ahermann86/LX79x_WiFi/README.md

# LX79x Mähroboter WiFi Erweiterung mit ESP32

Nachrüstung einer WiFi Schnittstelle mit Websteuerung für einen LandXcape LX79x Mähroboter

*Der Einsatz von diesem Projekt erfolgt auf eigene Gefahr! Der Ersteller kann nicht für Schäden haftbar gemacht werden. Sie können einen Verlust der Garantie und des Supports durch den Hersteller riskieren! Dieses Projekt ist keine offizielle Erweiterung des Roboters!*

<p align="center">
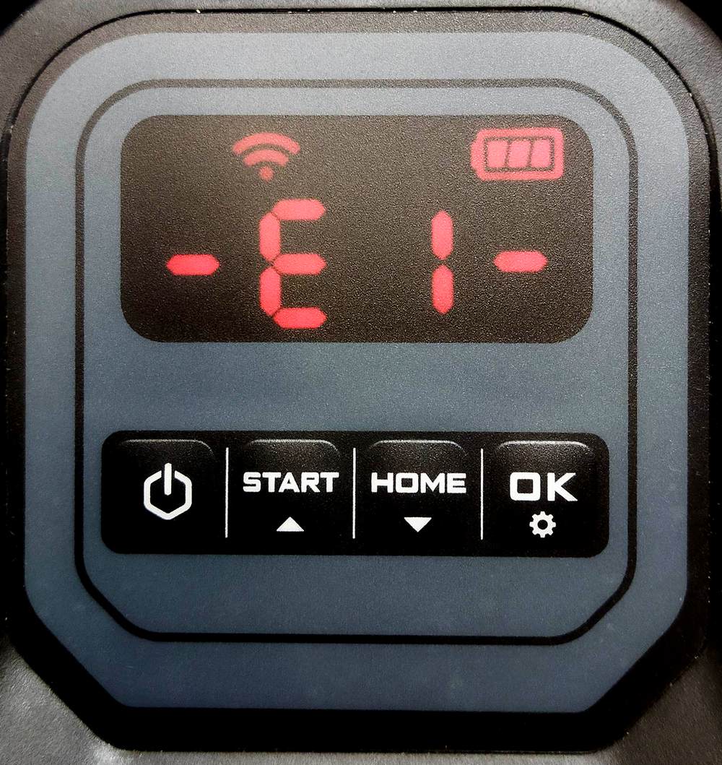
[picture p1: pic/Display.jpg]
  
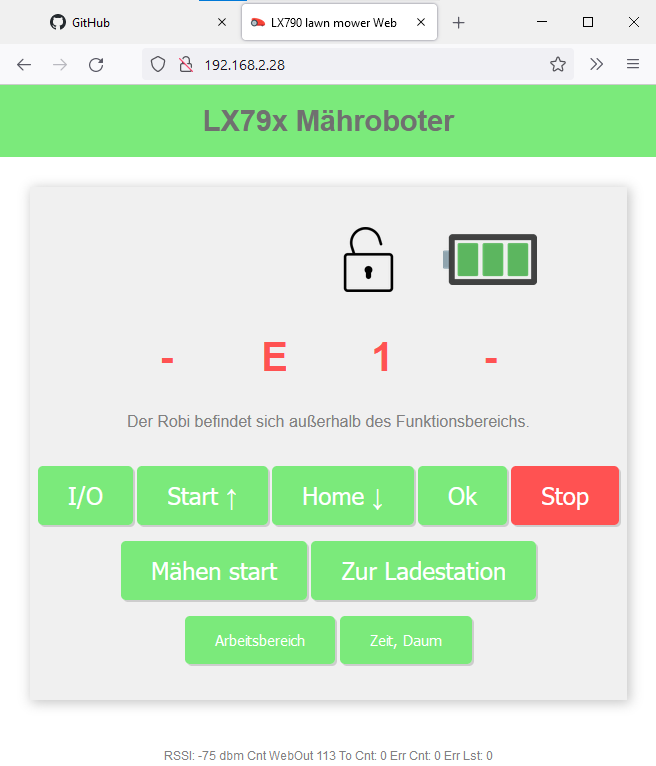
[picture p2: pic/Web_with_mower.png]
  
</p>

### Allgemein
- Fernauslesen des Displays
- Klartextausgabe der Fehlercodes
- Fernsteuern der Tasten und Funktionen
- Anbindung über den I2C Bus zwischen Display und Mainboard
- Wenn der Roboter in der Ladestation steht uns aus ist, kann dieser mit "I/O" eingeschaltet werden

### Voraussetzungen
#### Hardware
Zum Einsatz kommt der ESP32 auf dem Board "DOIT ESP32 DEVKIT V1". Dieser wurde gewählt, da er zwei Hardware I2C Schnittstellen besitzt. Das ist wichtig, da beim I2C Bus des Roboters das Timing nicht zu sehr beeinflusst werden darf.

##### Anbindung an den I2C Bus
Um den ESP32 in den I2C Bus zwischen Mainboard und Display zwischenschalten zu können, benötigt man ein Adapterkabel. Dabei muss am Roboter selbst nichts "umgebaut" werden. Es wird lediglich der Stecker des Displays ausgesteckt und ein Adapter wie folgt dazwischen gesteckt:
<p align="center">
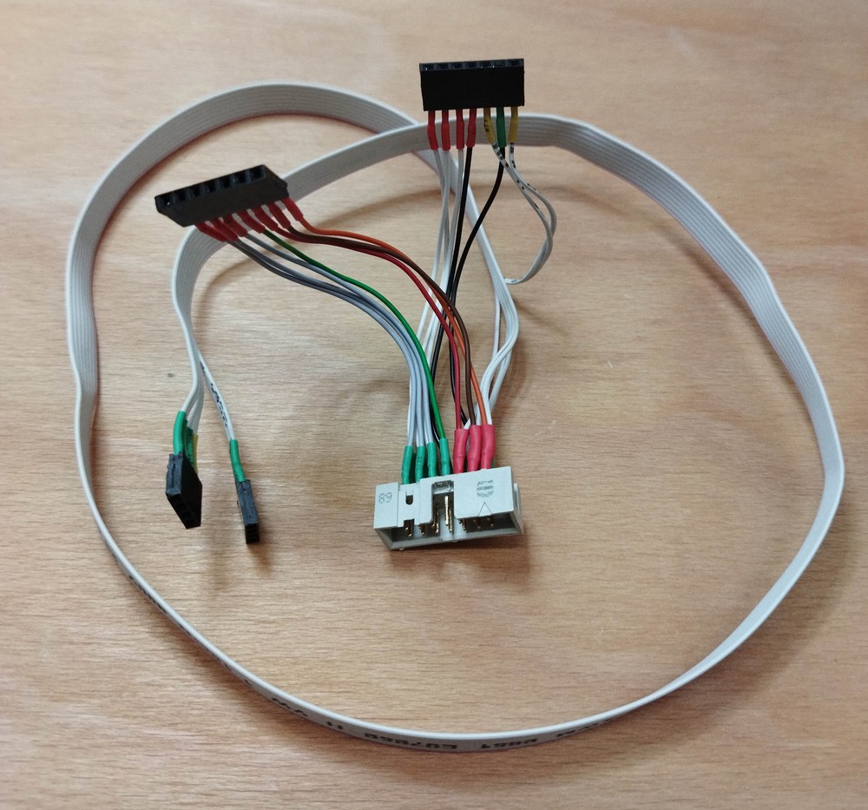
[picture p3: pic/Adapter_1.jpg]
  
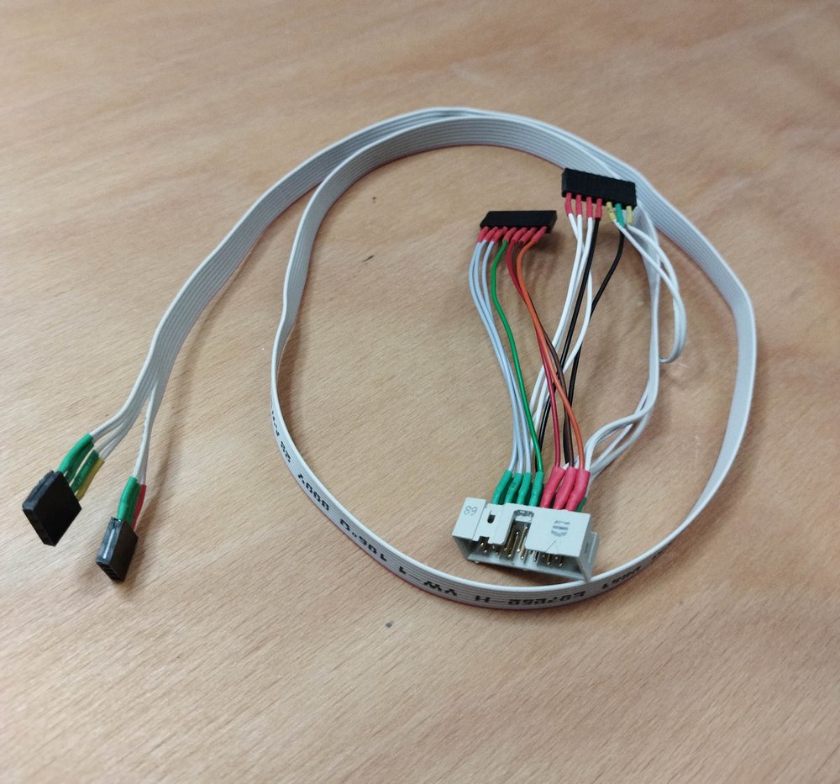
[picture p4: pic/Adapter_2.jpg]
  
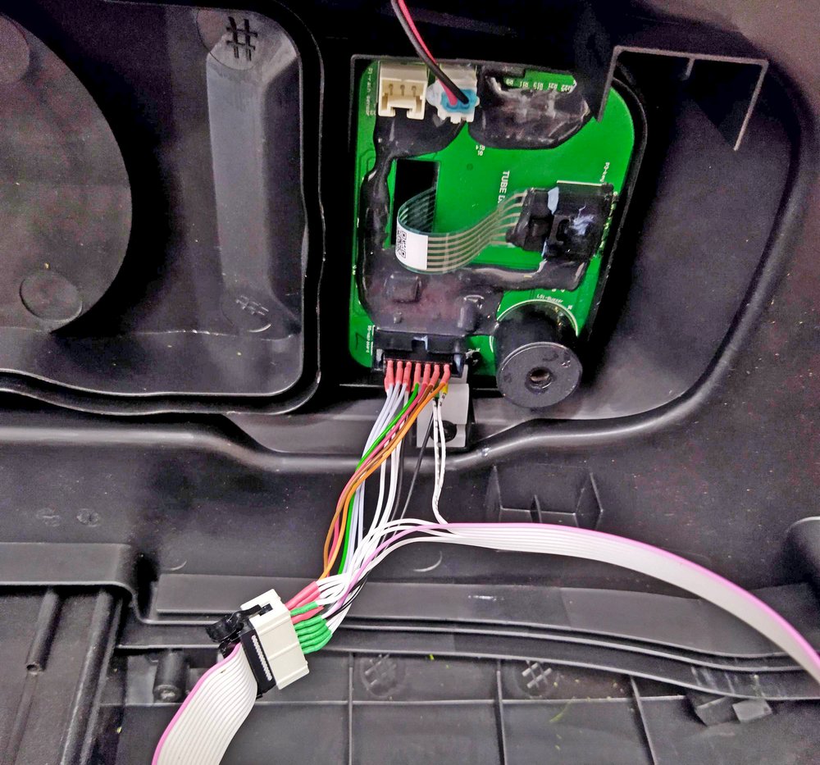
[picture p5: pic/Display_1.jpg]
    
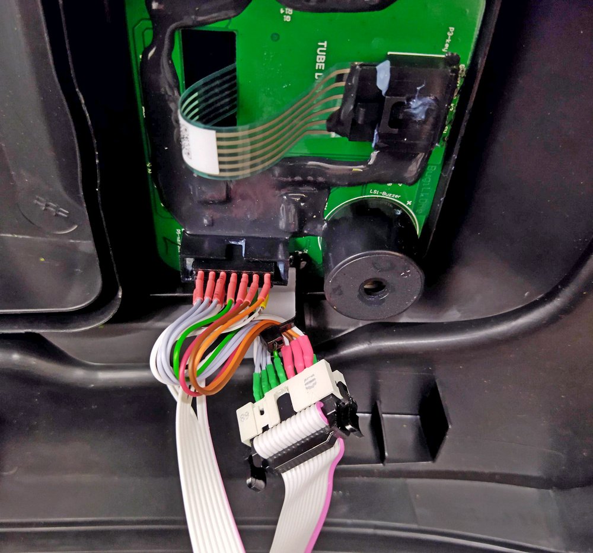
[picture p6: pic/Display_2.jpg]
    
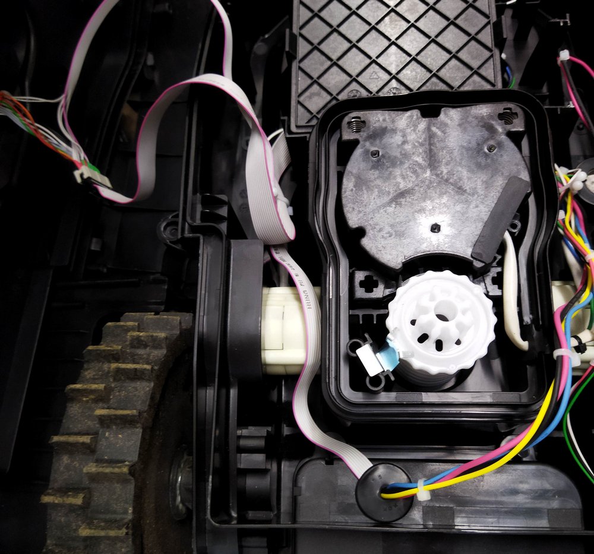
[picture p7: pic/Durchgang_1.jpg]
    
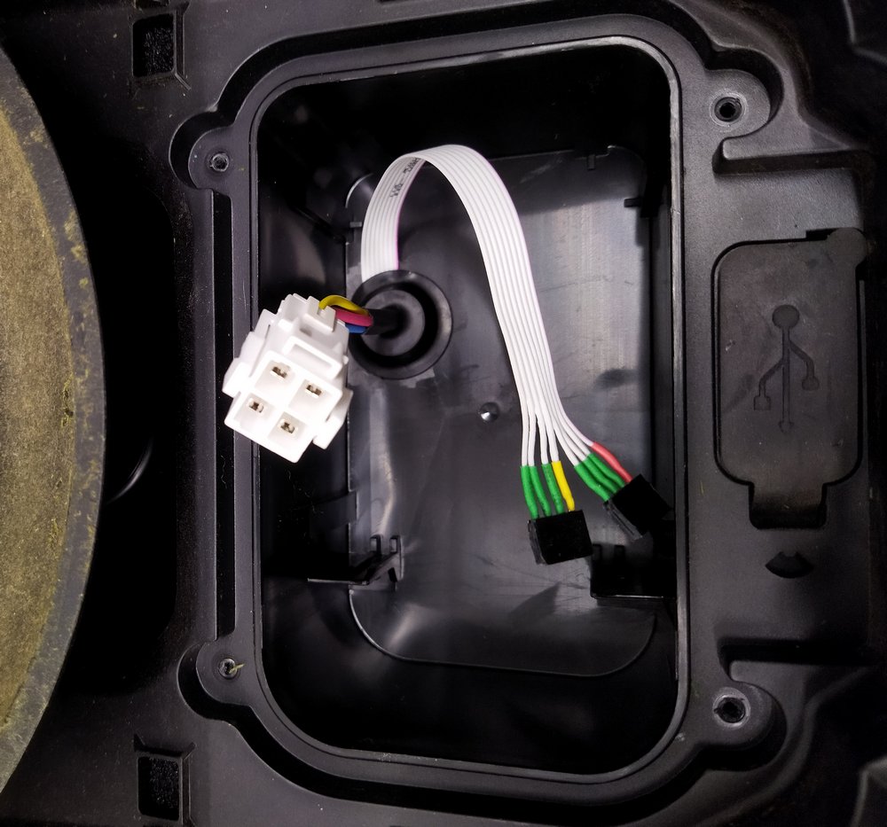
[picture p8: pic/Durchgang_2.jpg]
    
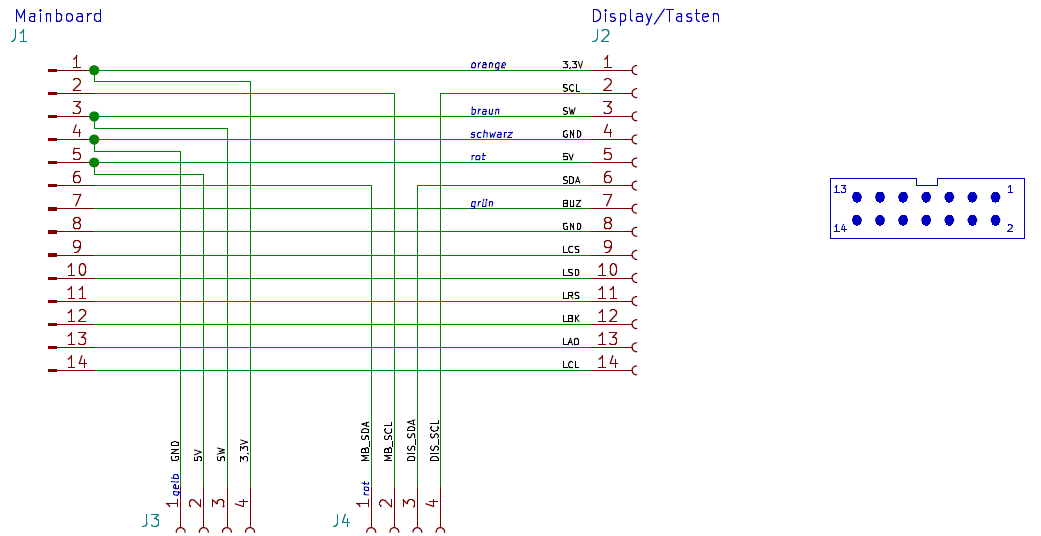
[picture p9: pic/Schaltplan_Adapter.png]
    
</p>

Das Adapterkabel hat eine Gesamtlänge von ca 70cm.

##### Platine
Der ESP32 wird auf eine Lochrasterplatine Adaptiert. Die fertige Platine kann dann in dem Batteriefach eingebaut werden.
<p align="center">
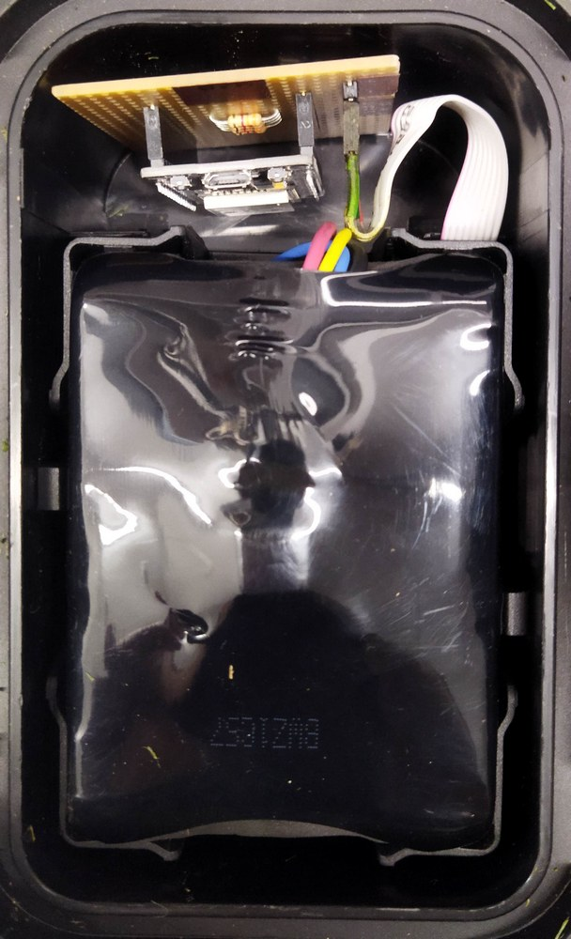
[picture p10: pic/Eingebaut_1.jpg]
  
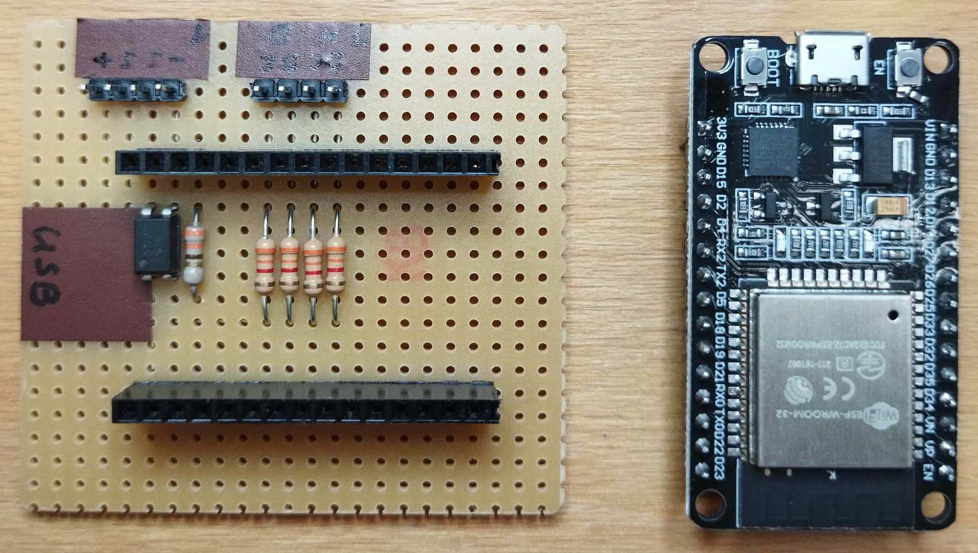
[picture p11: pic/Platine_1.jpg]
  
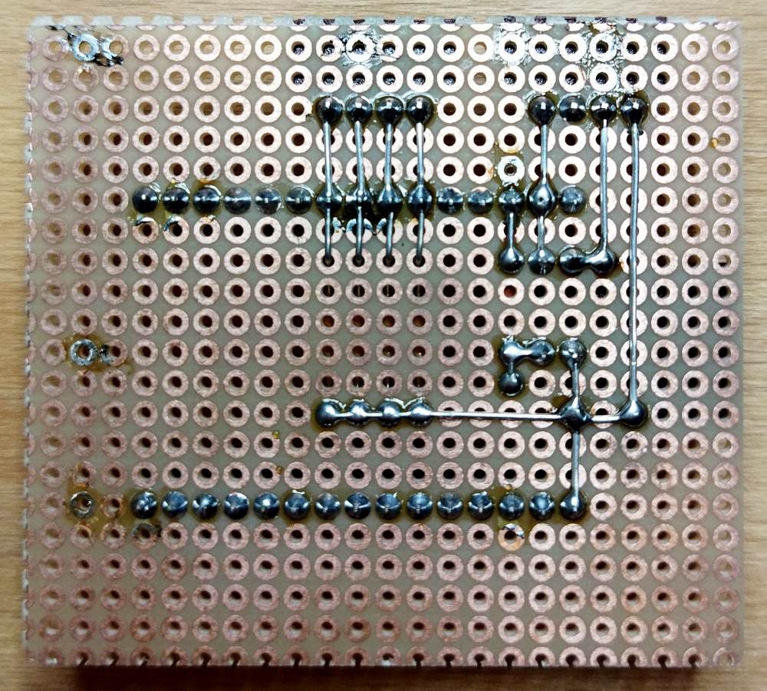
[picture p12: pic/Platine_2.jpg]
  
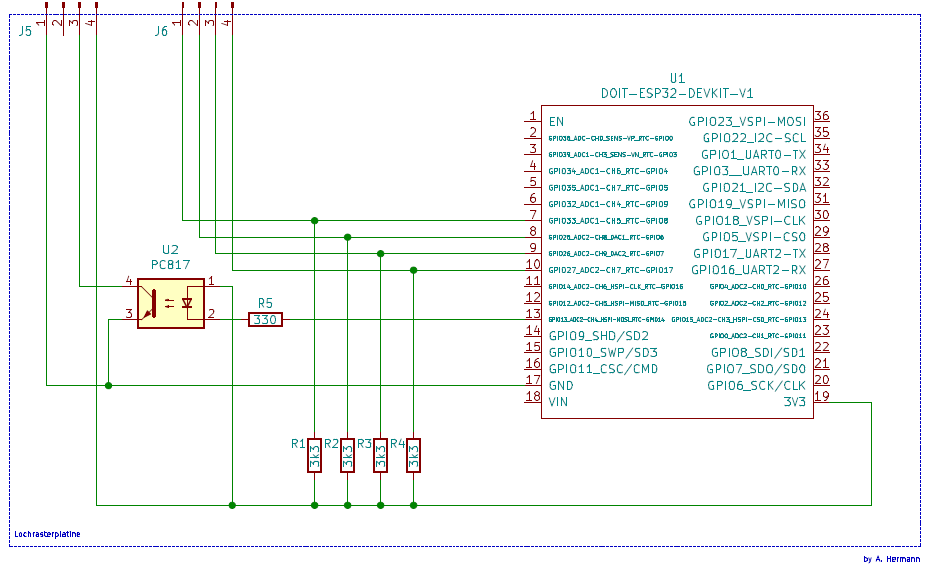
[picture p13: pic/Schaltplan_ESP32.png]
  
</p>

[Gesamter Schaltplan als PDF](pic/Schaltplan.pdf)

#### Software
Um den ESP32 programmieren und flashen zu können, wurde in diesem Projekt die Arduino IDE eingesetzt.

##### Folgende Voraussetzungen müssen dafür geschaffen werden:
1. Installation der aktuellen Arduino IDE
2. ESP32 Core installieren (https://docs.espressif.com/projects/arduino-esp32/en/latest/installing.html)
3. Boardtyp auswählen: 'Werkzeuge->Board->DOIT ESP32 DEVKIT V1'
4. CRC Bibliothek ergänzen: 'Werkzeuge->Bibliotheken verwalten...->CRC (Rob Tillaart)'
5. Filesystem Uploader: (https://randomnerdtutorials.com/install-esp32-filesystem-uploader-arduino-ide/)
  1. Download ESP32FS ZIP: https://github.com/me-no-dev/arduino-esp32fs-plugin/releases/
  2. ZIP direkt in "c:\Program Files (x86)\Arduino\tools\" entpacken
  3. Arduino IDE neu starten

##### ESP32 flashen/Programm und Daten uploaden:
1. Repository herunterladen und "ino" Projektdatei öffnen
2. ESP32 Board per USB verbinden und passende COM Schnittstelle auswählen: 'Werkzeuge->Port'
3. Im .ino Code die WiFi Zugangsdaten anpassen:
```c
const char* ssid     = "DEINESSID";
const char* password = "DEINPASSWORT";
```
4. Ordner "data" mit 'Werkzeuge->ESP32 Sketch Data Upload' hochladen
5. Seriellen Monitor öffnen
6. Projekt kompilieren und hochladen
7. Über Seriellen Monitor kontrollieren ob WiFi Verbindung besteht und IP Adresse, welche vom DHCP Server vergeben wurde, ermitteln bzw. merken.

### Anwendung
#### Webbrowser
Das Webinterface kann direkt mit der IP Adresse aufgerufen werden:
<p align="center">
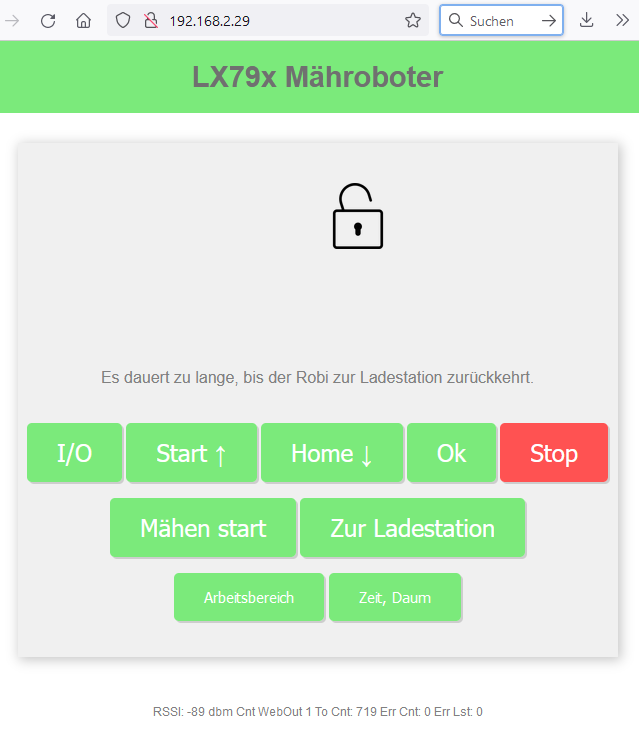
[picture p14: pic/Web_without_mower.png]
  
</p>

#### HTTP Anfragemethoden
##### Befehle Senden
http://MOWERADRESS/cmd?parm=[COMMAND]&value=[VALUE]

param=[COMMAND]:

- start -> Taste Start bzw. hoch
- home -> Taste Home bzw. runter
- ok -> Taste Ok
- stop -> Taste Stop
- workzone -> Arbeitsbereich einstellen
- timedate -> Zeit und Datum einstellen
- startmow -> "Mähen" starten
- homemow -> "Zurück zur Ladestation" starten

value=[VALUE]:

- Bei "start, home, ok, stop" ist [VALUE] die Dauer in ms des Tastendrucks ansonsten muss 1 übergeben werden.

>Beispiel - die Taste Start soll 5 Sekunden gedrückt werden:
>
>http://MOWERADRESS/cmd?parm=start&value=5000

##### Zustand Abfragen
http://MOWERADRESS/statval

Antwort:
[Display];[RSSI];[Batteriestatus];[Klartext]

>Beispiel bei Fehler:
>
>-E8-;-83;off;Es dauert zu lange, bis der Robi zur Ladestation zurückkehrt.
>
>Beispiel während dem Mähen:
>
>|--|;-80;mid;Mähen...

##### Beispiel
Einbindung in FHEM per HTTPMOD:

```
defmod MRoboter HTTPMOD none 5
attr MRoboter alias MRoboter
attr MRoboter event-on-change-reading .*
attr MRoboter get01-1Name Display
attr MRoboter get01-2Name RSSI
attr MRoboter get01-3Name Battery
attr MRoboter get01-4Name Status
attr MRoboter get01Decode UTF-8
attr MRoboter get01Name Ouput
attr MRoboter get01Poll 1
attr MRoboter get01Regex (\N+);;(\N+);;(\N+);;(\N+)
attr MRoboter get01URL http://192.168.2.54:80/statval
attr MRoboter group Mähroboter
attr MRoboter room Haus
attr MRoboter showBody 1
attr MRoboter stateFormat D: Display WL: RSSI S: Status B: Battery
```

Eine Aufzeichnung sieht dann so aus:

<p align="center">
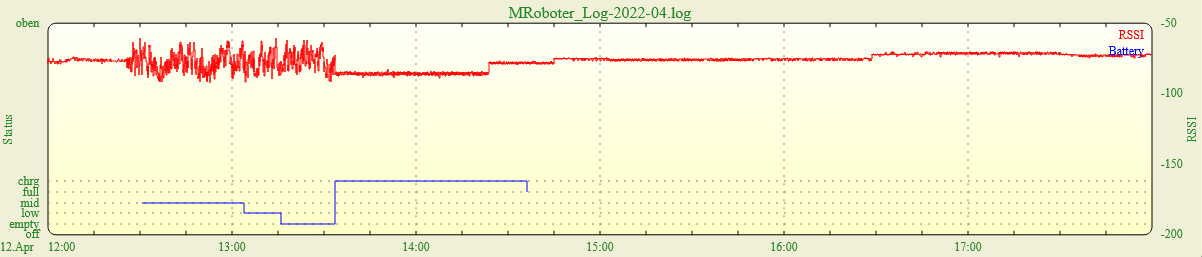
[picture p15: pic/LogPlot_mit_FHEM.png]
  
</p>

##### Update ausführen
http://MOWERADRESS/update

Damit kann eine .bin Datei auf den ESP32 hochgeladen werden.
