ahermann86/LX79x_WiFi/pic/Oszi_01Req_01Res.PNG

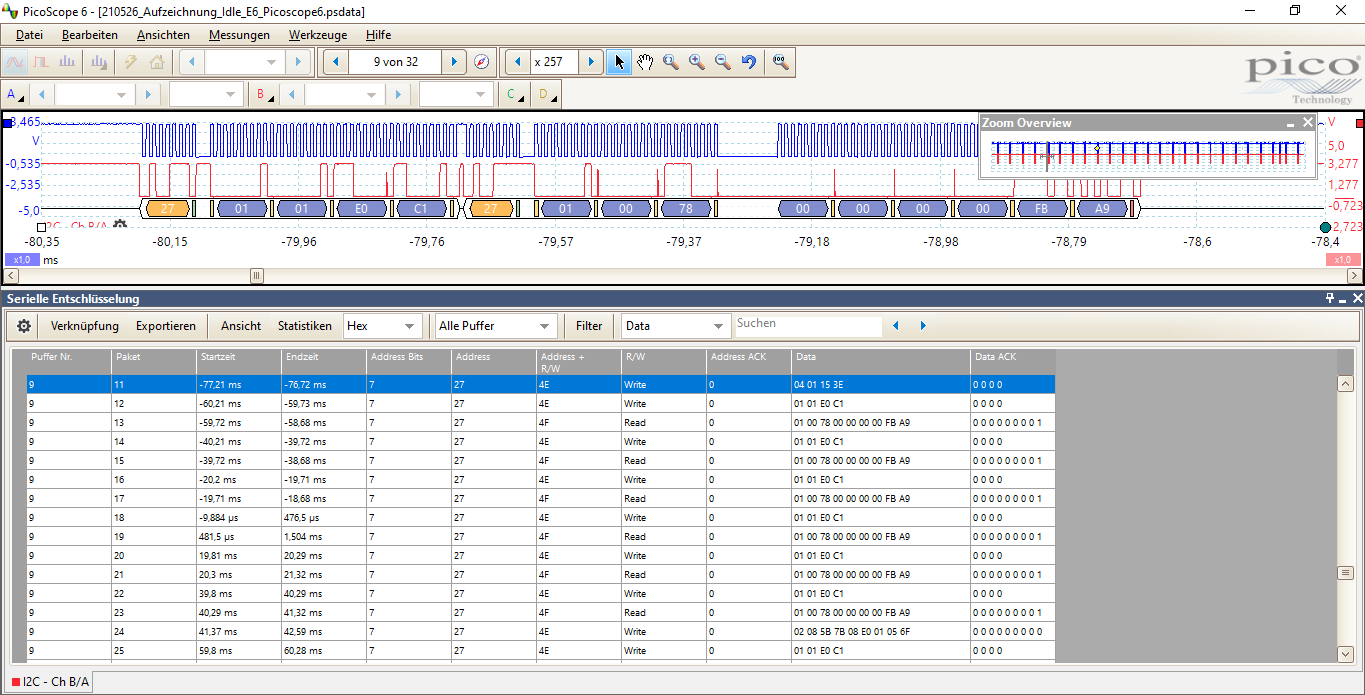
pic/Oszi_01Req_01Res.PNG
