ahermann86/LX79x_WiFi/pic/Oszi_02Res.PNG

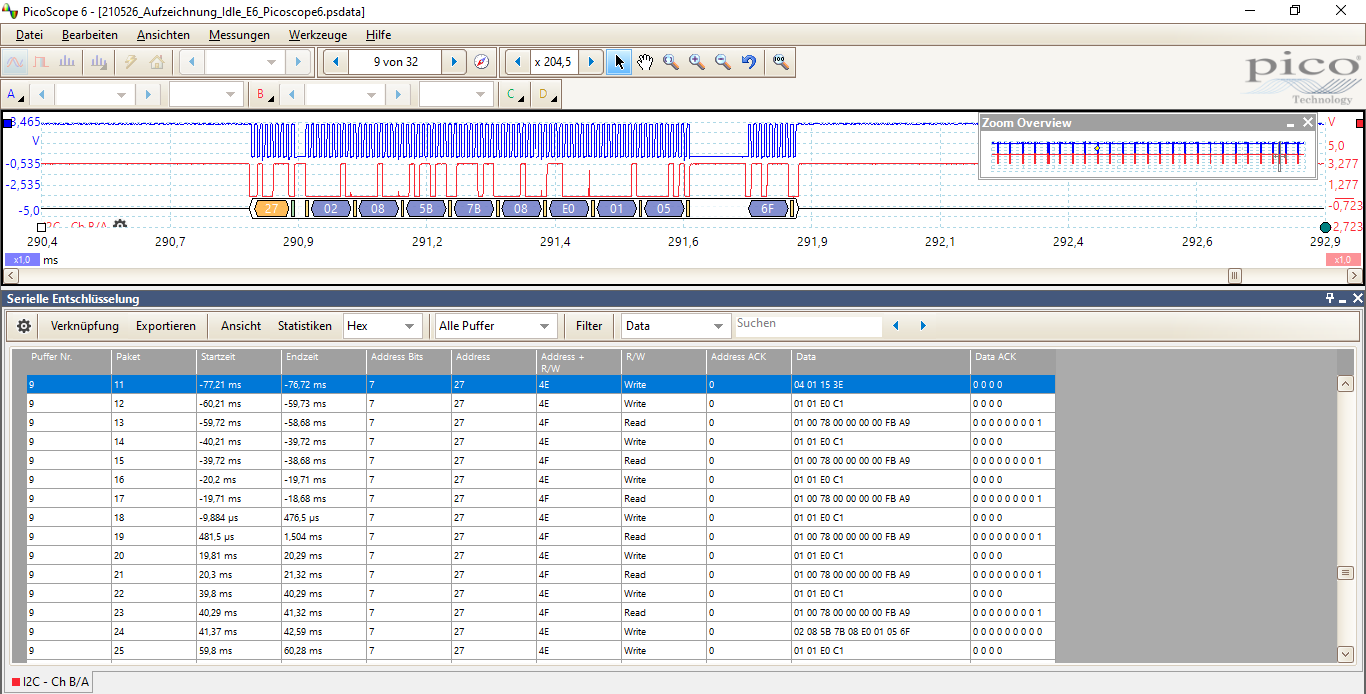
pic/Oszi_02Res.PNG
