ahermann86/LX79x_WiFi/src/data/bat_empty.png

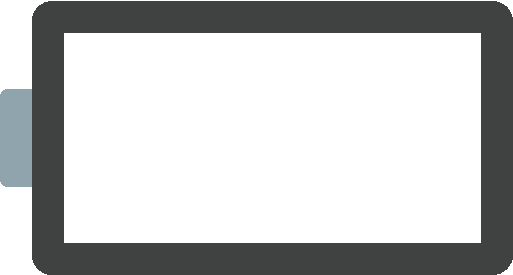
src/data/bat_empty.png
