ahermann86/LX79x_WiFi/src/data/bat_full.png

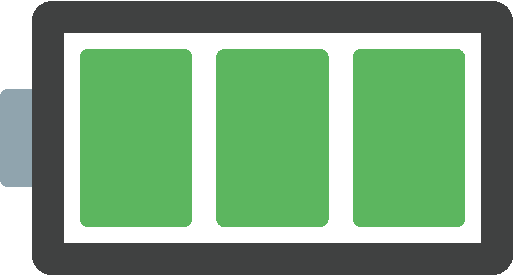
src/data/bat_full.png
