ahermann86/LX79x_WiFi/src/data/bat_low.png

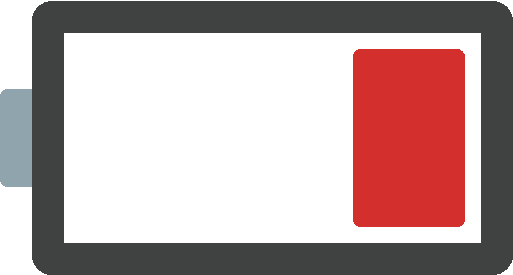
src/data/bat_low.png
