ahermann86/LX79x_WiFi/src/data/bat_mid.png

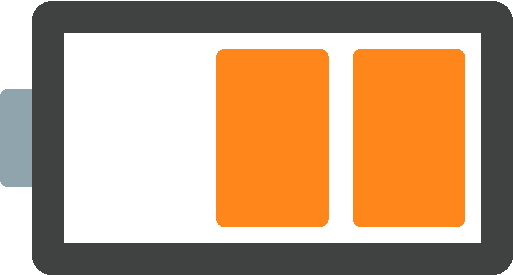
src/data/bat_mid.png
