ahermann86/LX79x_WiFi/src/data/clock.png

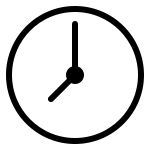
src/data/clock.png
