ahermann86/LX79x_WiFi/src/data/locked.png

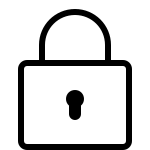
src/data/locked.png
