ahermann86/LX79x_WiFi/(threads)

Thread 3 (2021-11-03):

[FR] PIN Eingabe einbauen

Henry-Sir, 2021-11-03:
Ist es möglich die PIN Eingabe mit einzubauen?

- PIN sollte über Web Interface speicherbar sein

**Manuell über Webinterface**
- über seperaten Button den abgespeicherten PIN eingeben

**Automatisiert**
- wenn ESP sich mit dem WLAN verbunden hat, dann wird PIN automatisch eingeben (wenn keine Verbindung zum WLAN, dann auch keine automatische PIN Eingabe -> zum Schutz)

Thread 4 (2022-05-21):

[Question] What do the rest of the cables do?

sanchosk, 2022-05-21:
First of all, AMAZING project - I'll be building it this weekend or latest the next one. Thanks, I always wanted my lawnmower to be wifi without the chinese registration site.
I wonder if you have any idea what the rest of the cables in the 14pin connector are?

ahermann86, 2022-05-25:
I'm glad to read that. My ambition is to be cloud-free as far as possible ;)

I assume that the lines (LCL LAD LBK LRS LSD LCS) are signals for the gyroscope.

Closed 2022-05-25.

Thread 5 (2022-05-25):

Unable to compile - newer ESP32 libs fail i2c slave init

sanchosk, 2022-05-25:
The problem is with newer i2c libs for ESP32.
The new version requires the clk_speed to be initialized to 0, otherwise it will assign undetermined value and fail.
See this thread:
https://www.esp32.com/viewtopic.php?t=21030

sanchosk, 2022-05-25:
I've added following code on line 28 of file ahWire.cpp:
  memset(&config, 0, sizeof(config)); //Might require to #include "string.h"
and on line 36:
  config.clk_flags = 0;

This made the code compilation OK, but after connecting it to the mower, I can't see anything on the display.
It beeps around each 20 seconds, but not much more. I can't see any debug messages on the serial port other than the fact it's connected to the wifi.
Any ideas how to debug?

ahermann86, 2022-05-30:
Hi sanchosk,
I have adapted the code in ahWireSlave.cpp and LX790_ESP32.ino so that it can be compiled with Core Version 2.0.3. I tested this with my mower and it works like this. The only thing I noticed is that the host name is no longer set by the ESP and my Fritzbox gives a new address via DHCP... Maybe this is a new ESP bug?

sanchosk, 2022-06-12:
OK, with your latest update and me changing the pins the other way around (input was output and output was input), I finally got something on the display. Does not yet work as it should, but at least it displays what it should and the buttons work. Now to wait until Monday to test actual grass cutting and then I can add MQTT to the module ;)

Closed 2022-06-12.

Thread 6 (2022-07-07):

Leider nicht kompatibel mit LX790.1

4nuky, 2022-07-07:
Hallo zusammen,

ich bin total begeistert von diesem Projekt und hab mir deshalb auch einen LX790 aus dem Baumarkt gegönnt. Es ist die Variante LX790.1.

 Platine war gelötet und ich wollte zum Einbau kommen aber leider musste ich feststellen, dass der Wannenstecker nicht 14 sondern 16 Pins hat.

Alle Buttons werden direkt an das Mainboard weitergeleitet und nicht über den Bus.

Die I2C pins SDA/SCL sind zwar vorhanden aber ohne Funktion. Der Display Treiber ist ein TM1668 der über DIO/CLK/STB kommuniziert (wohl ein unidirektionales SPI).

Infos inkl. Datenblatt gibt’s auf der git Seite der  [Arduino Library](https://github.com/maxint-rd/TM16xx).

Daher vermute ich dass der Code „nur“ mit dem Display Treiber „TM1650“ kompatibel ist, weil nur hier die rede von I2C ist.

Natürlich könnte man hier auch die Kommunikation in ähnlicher Weise belauschen wie Axel das für I2C umgesetzt hat, aber meine Fähigkeiten übersteigt das jedenfalls :D. Man müsste ja quasi die Library umdrehen.

Vielleicht freut sich jemand wenn der Hinweis in die Readme kommt.

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

the-real-orca, 2022-09-01:
Ich habe auch die neue Version vom LX790 (Display Board: LX890 Tube Display V1.1) und die letzten Tage damit verbracht das Board zu analysieren Protokoll zu dekodieren.
Die Buttons sind jetzt direkt ans Flachbandkabel gelegt, was die Sache etwas vereinfacht. Dafür verwendet das Display ein anderes Protokoll (SPI statt I2C) und die Belegung der Anzeige (Grids, Segmente) scheint auch komplett anders zu sein.

Ich muss mich allerdings noch in das Projekt einarbeiten und sehen wie leicht der kommunikationsspezifische Teil erweitert / ausgetauscht werden kann. Am schönsten wäre ein Projekt mit verschiedenen Konfigurationsvarianten. Wenn das zu kompliziert wird, wird’s ein Spin-Off Projekt.

Senserich, 2023-07-28:
Hallo zusammen,
gibt es in der Zwischenzeit eine Lösung für die neue Platine LX790.1? Es wäre sehr schade, wenn dieses schöne Projekt beim aktuellen LX790 nicht mehr zu gebrauchen wäre.

BIIINO, 2023-08-17:
Guten Tag, wäre es möglich, dieses Projekt für die 16-Pin-Version des Mähers mit der LX790.1-Platine zu verwenden?

Übersetzt mit Google Übersetzer

Wlad2288, 2023-09-10:
Hallo und auch danke von meiner Seite für das tolle Project.
Leider habe auch ich einen 16 poligen Stecker :(
Ich wäre auch sehr dankbar, wenn das Projekt auch für neuere Modelle angepasst wird.

the-real-orca, 2023-09-12:
Ich habe vor einiger Zeit begonnen [LX79x_WiFi](https://github.com/the-real-orca/LX79x_WiFi) für die Version 1.1 (16 poliges Kabel) zu portieren.

Die erste Testversion läuft seit dem Sommer bei mir im Garten.
Der Fork ist unter
[https://github.com/the-real-orca/LX79x_WiFi]
Wichitg: [LX790_V1_1](https://github.com/the-real-orca/LX79x_WiFi/tree/LX790_V1_1/docs/LX790_V1_1) den Branch wählen!

Die Doku ist noch nicht aktualisiert, aber mit den Bildern bzw. Protokollbeschreibung sollten es hoffentlich auch so nachvollziehbar sein.

Wlad2288, 2023-09-13:
> Ich habe vor einiger Zeit begonnen [LX79x_WiFi](https://github.com/the-real-orca/LX79x_WiFi) für die Version 1.1 (16 poliges Kabel) zu portieren. Die erste Testversion läuft seit dem Sommer bei mir im Garten. Der Fork ist unter: https://github.com/the-real-orca/LX79x_WiFi Wichitg: [LX790_V1_1](https://github.com/the-real-orca/LX79x_WiFi/tree/LX790_V1_1/docs/LX790_V1_1) den Branch wählen!
>
> Die Doku ist noch nicht aktualisiert, aber mit den Bildern bzw. Protokollbeschreibung sollten es hoffentlich auch so nachvollziehbar sein.

MEGA!
Vielen Dank dafür! Habe ehrlich gesagt nicht damit gerechnet - umso größer ist meine Freude :)

Habe mir gerade anhand deines Schaltplans alle Bauteile bei Reichelt bestellt.
Dabei ist mir aufgefallen, dass nur noch ein Widerstand gebraucht wird - mich interessieren die Gründe hierfür.

Ich werde berichten, sobald ich alles fertig habe und es im Einsatz ist!

Besten Dank,
Wlad

the-real-orca, 2023-09-13:
In der HW Version 1.1 verwenden sie I2C als Kommunikationsprotokoll, da sind die Pull-Up Widerstande schon am Board verbaut. Das reinhängen mit dem ESP ist da etwas tricky weil er nur lauschen darf und ich die eigentliche Kommunikation nicht beeinflussen möchte. Manchmal dürfte es Probleme beim sync geben und er kann dann die Packet nicht richtig decodieren.  Hab aber noch nicht herausgefunden wie man das stabiler machen kann.

Die anderen Leitungen sind für die Tasten. Bei einem virtuellen Tastendruck wird die Leitung auf GND gezogen, ansonsten hängt sie am Board internen Pull-Up.

D.h. bis auf den OptoKoppler + Vorwiderstand braucht man nix mehr an zusätzlicher HW (außer den ESP natürlich :-)

Wlad2288, 2023-09-14:
Danke für die Erklärung!
Wie machen sich die Sync-Probleme bemerkbar und was machst du dann in diesem Fall?

the-real-orca, 2023-09-20:
Hin und wieder kommt es zu Artefakten bei der Webanzeige. Hat aber auf den normalen Betrieb keinen Einfluss.

Senserich, 2024-03-09:
Wie ist eigentlich die Testphase im vergangenen Sommer verlaufen? Da die nächste Saison vor der Tür steht, überlege ich, dieses Projekt ebenfalls zu nutzen.

the-real-orca, 2024-03-22:
Wie gesagt, bis auf vereinzelte Artefakte bei der Anzeige, hat alles wunderbar funktioniert.

Wlad2288, 2024-04-12:
Danke @the-real-orca!
Ich komme erst jetzt dazu das Projekt umzusetzen, nachdem der ESP32 ein Jahr lang in der Schublade lag :)
Leider bin ich ein absoluter Anfänger in dem Bereich und kriege folgenden Error nicht selbst gelöst:

```
Arduino: 1.8.19 (Mac OS X), Board: "DOIT ESP32 DEVKIT V1, 80MHz, 921600, None, Disabled"

/Users//Downloads/LX79x_WiFi-LX790_V1_1/LX790_ESP32/HAL_LX790_V1_1.cpp: In function 'void HAL_loop(LX790_State&)':
HAL_LX790_V1_1.cpp:155:14: error: 'using ESP32SPISlave = class arduino::esp32::spi::slave::Slave' {aka 'class arduino::esp32::spi::slave::Slave'} has no member named 'remained'
   if (tm1668.remained() == 0)
              ^~~~~~~~
HAL_LX790_V1_1.cpp:156:59: error: no matching function for call to 'arduino::esp32::spi::slave::Slave::queue(uint8_t [32], unsigned int)'
     tm1668.queue(spi_slave_rx_buf, sizeof spi_slave_rx_buf);
                                                           ^
In file included from /Users//Downloads/LX79x_WiFi-LX790_V1_1/LX790_ESP32/HAL_LX790_V1_1.cpp:5:
/Users//Documents/Arduino/libraries/ESP32SPISlave/ESP32SPISlave.h:342:10: note: candidate: 'bool arduino::esp32::spi::slave::Slave::queue(const uint8_t*, uint8_t*, size_t)'
     bool queue(const uint8_t* tx_buf, uint8_t* rx_buf, size_t size)
          ^~~~~
/Users//Documents/Arduino/libraries/ESP32SPISlave/ESP32SPISlave.h:342:10: note:   candidate expects 3 arguments, 2 provided
/Users//Documents/Arduino/libraries/ESP32SPISlave/ESP32SPISlave.h:356:10: note: candidate: 'bool arduino::esp32::spi::slave::Slave::queue(uint32_t, const uint8_t*, uint8_t*, size_t)'
     bool queue(
          ^~~~~
/Users//Documents/Arduino/libraries/ESP32SPISlave/ESP32SPISlave.h:356:10: note:   candidate expects 4 arguments, 2 provided
HAL_LX790_V1_1.cpp:159:17: error: 'using ESP32SPISlave = class arduino::esp32::spi::slave::Slave' {aka 'class arduino::esp32::spi::slave::Slave'} has no member named 'available'
   while (tm1668.available()) {
                 ^~~~~~~~~
HAL_LX790_V1_1.cpp:160:23: error: 'using ESP32SPISlave = class arduino::esp32::spi::slave::Slave' {aka 'class arduino::esp32::spi::slave::Slave'} has no member named 'size'
     int size = tm1668.size();
                       ^~~~
HAL_LX790_V1_1.cpp:180:12: error: 'using ESP32SPISlave = class arduino::esp32::spi::slave::Slave' {aka 'class arduino::esp32::spi::slave::Slave'} has no member named 'pop'
     tm1668.pop();
            ^~~
Multiple libraries were found for "WiFi.h"
 Used: /Users//Library/Arduino15/packages/esp32/hardware/esp32/2.0.15/libraries/WiFi
 Not used: /Applications/Arduino.app/Contents/Java/libraries/WiFi
exit status 1
'using ESP32SPISlave = class arduino::esp32::spi::slave::Slave' {aka 'class arduino::esp32::spi::slave::Slave'} has no member named 'remained'

This report would have more information with
"Show verbose output during compilation"
option enabled in File -> Preferences.
```

Any idea?

Senserich, 2024-04-13:
Bei mir leider ein ähnliches Ergebnis. Das Fehlerprotokoll ist sogar noch etwas länger. Ich verwende Windows 10 und habe die Arduino-Versionen 1.18.19 und 2.3.2 getestet. Das Resultat ist bei beiden gleich. Wahrscheinlich fehlen bei mir irgendwelche Bibliotheken. Konnte aber diesbezüglich keinen direkten Hinweis im Fehlerprotokoll finden.

`Arduino: 1.8.19 (Windows 10), Board: "DOIT ESP32 DEVKIT V1, 80MHz, 115200, None, Disabled"

In file included from E:\13.LX790_ESP32\src\LX790_ESP32\HAL_LX790_V1_1.cpp:7:
D:\Arduino\libraries\ESP32SPISlave/ESP32SPISlave.h: In member function 'bool arduino::esp32::spi::slave::Slave::initialize(uint8_t)':
D:\Arduino\libraries\ESP32SPISlave/ESP32SPISlave.h:615:14: error: 'string' is not a member of 'std'
  615 |         std::string task_name = std::string("spi_slave_task_") + std::to_string(this->ctx.if_cfg.spics_io_num);
      |              ^~~~~~
D:\Arduino\libraries\ESP32SPISlave/ESP32SPISlave.h:8:1: note: 'std::string' is defined in header '<string>'; did you forget to '#include <string>'?
    7 | #include <driver/spi_slave.h>
  +++ |+#include <string>
    8 | #include <vector>
D:\Arduino\libraries\ESP32SPISlave/ESP32SPISlave.h:616:59: error: 'task_name' was not declared in this scope; did you mean 'basename'?
  616 |         int ret = xTaskCreatePinnedToCore(spi_slave_task, task_name.c_str(), SPI_SLAVE_TASK_STASCK_SIZE, static_cast<void*>(&this->ctx), SPI_SLAVE_TASK_PRIORITY, &spi_task_handle, 1);
      |                                                           ^~~~~~~~~
      |                                                           basename
E:\13.LX790_ESP32\src\LX790_ESP32\HAL_LX790_V1_1.cpp: In function 'void HAL_loop(LX790_State&)':
HAL_LX790_V1_1.cpp:157:14: error: 'using ESP32SPISlave = class arduino::esp32::spi::slave::Slave' {aka 'class arduino::esp32::spi::slave::Slave'} has no member named 'remained'
  157 |   if (tm1668.remained() == 0) {
      |              ^~~~~~~~
HAL_LX790_V1_1.cpp:158:17: error: no matching function for call to 'arduino::esp32::spi::slave::Slave::queue(uint8_t [32], unsigned int)'
  158 |     tm1668.queue(spi_slave_rx_buf, sizeof spi_slave_rx_buf);
      |     ~~~~~~~~~~~~^~~~~~~~~~~~~~~~~~~~~~~~~~~~~~~~~~~~~~~~~~~
D:\Arduino\libraries\ESP32SPISlave/ESP32SPISlave.h:342:10: note: candidate: 'bool arduino::esp32::spi::slave::Slave::queue(const uint8_t*, uint8_t*, size_t)'
  342 |     bool queue(const uint8_t* tx_buf, uint8_t* rx_buf, size_t size)
      |          ^~~~~
D:\Arduino\libraries\ESP32SPISlave/ESP32SPISlave.h:342:10: note:   candidate expects 3 arguments, 2 provided
D:\Arduino\libraries\ESP32SPISlave/ESP32SPISlave.h:356:10: note: candidate: 'bool arduino::esp32::spi::slave::Slave::queue(uint32_t, const uint8_t*, uint8_t*, size_t)'
  356 |     bool queue(
      |          ^~~~~
D:\Arduino\libraries\ESP32SPISlave/ESP32SPISlave.h:356:10: note:   candidate expects 4 arguments, 2 provided
HAL_LX790_V1_1.cpp:162:17: error: 'using ESP32SPISlave = class arduino::esp32::spi::slave::Slave' {aka 'class arduino::esp32::spi::slave::Slave'} has no member named 'available'
  162 |   while (tm1668.available()) {
      |                 ^~~~~~~~~
HAL_LX790_V1_1.cpp:163:23: error: 'using ESP32SPISlave = class arduino::esp32::spi::slave::Slave' {aka 'class arduino::esp32::spi::slave::Slave'} has no member named 'size'
  163 |     int size = tm1668.size();
      |                       ^~~~
HAL_LX790_V1_1.cpp:183:12: error: 'using ESP32SPISlave = class arduino::esp32::spi::slave::Slave' {aka 'class arduino::esp32::spi::slave::Slave'} has no member named 'pop'
  183 |     tm1668.pop();
      |            ^~~
In file included from C:\Users\\AppData\Local\Arduino15\packages\esp32\hardware\esp32\3.0.0-alpha3\cores\esp32/WString.h:26,
                 from C:\Users\\AppData\Local\Arduino15\packages\esp32\hardware\esp32\3.0.0-alpha3\cores\esp32/Arduino.h:189,
                 from D:\Arduino\libraries\Arduino_JSON\src/JSON.h:23,
                 from D:\Arduino\libraries\Arduino_JSON\src/Arduino_JSON.h:23,
                 from E:\13.LX790_ESP32\src\LX790_ESP32\LX790_ESP32.ino:1:
D:\Arduino\libraries\ArduinoJson\src/ArduinoJson/Polyfills/pgmspace_generic.hpp: In function 'const T* ArduinoJson::V704PB2::detail::pgm_read(const T* const*)':
C:\Users\\AppData\Local\Arduino15\packages\esp32\hardware\esp32\3.0.0-alpha3\cores\esp32/pgmspace.h:52:16: error: expected ';' before '_addr'
   52 |   typeof(addr) _addr = (addr); \
      |                ^~~~~
C:\Users\\AppData\Local\Arduino15\packages\esp32\hardware\esp32\3.0.0-alpha3\cores\esp32/pgmspace.h:53:21: error: '_addr' was not declared in this scope
   53 |   *(void * const *)(_addr); \
      |                     ^~~~~
In file included from D:\Arduino\libraries\Arduino_JSON\src/JSON.h:25:
D:\Arduino\libraries\ArduinoJson\src/ArduinoJson/Polyfills/pgmspace_generic.hpp: In function 'uint32_t ArduinoJson::V704PB2::detail::pgm_read(const uint32_t*)':
D:\Arduino\libraries\Arduino_JSON\src/JSONVar.h:27:16: error: 'typeof_' was not declared in this scope; did you mean 'typeof'?
   27 | #define typeof typeof_
      |                ^~~~~~~
C:\Users\\AppData\Local\Arduino15\packages\esp32\hardware\esp32\3.0.0-alpha3\cores\esp32/pgmspace.h:45:28: error: '_addr' was not declared in this scope
   45 |   *(const unsigned long *)(_addr); \
      |                            ^~~~~
C:\Users\\AppData\Local\Arduino15\packages\esp32\hardware\esp32\3.0.0-alpha3\cores\esp32/pgmspace.h:43:30: error: void value not ignored as it ought to be
   43 | #define pgm_read_dword(addr) ({ \
      |                              ^~~~
   44 |   typeof(addr) _addr = (addr); \
      |   ~~~~~~~~~~~~~~~~~~~~~~~~~~~~~~
   45 |   *(const unsigned long *)(_addr); \
      |   ~~~~~~~~~~~~~~~~~~~~~~~~~~~~~~~~~~
   46 | })
      | ~~                    
D:\Arduino\libraries\ArduinoJson\src/ArduinoJson/Polyfills/pgmspace_generic.hpp: In function 'float ArduinoJson::V704PB2::detail::pgm_read(const float*)':
D:\Arduino\libraries\Arduino_JSON\src/JSONVar.h:27:16: error: 'typeof_' was not declared in this scope; did you mean 'typeof'?
   27 | #define typeof typeof_
      |                ^~~~~~~
C:\Users\\AppData\Local\Arduino15\packages\esp32\hardware\esp32\3.0.0-alpha3\cores\esp32/pgmspace.h:49:20: error: '_addr' was not declared in this scope
   49 |   *(const float *)(_addr); \
      |                    ^~~~~
C:\Users\\AppData\Local\Arduino15\packages\esp32\hardware\esp32\3.0.0-alpha3\cores\esp32/pgmspace.h:47:30: error: void value not ignored as it ought to be
   47 | #define pgm_read_float(addr) ({ \
      |                              ^~~~
   48 |   typeof(addr) _addr = (addr); \
      |   ~~~~~~~~~~~~~~~~~~~~~~~~~~~~~~
   49 |   *(const float *)(_addr); \
      |   ~~~~~~~~~~~~~~~~~~~~~~~~~~
   50 | })
      | ~~                    
D:\Arduino\libraries\ArduinoJson\src/ArduinoJson/Polyfills/pgmspace_generic.hpp: In instantiation of 'const T* ArduinoJson::V704PB2::detail::pgm_read(const T* const*) [with T = char]':
D:\Arduino\libraries\ArduinoJson\src/ArduinoJson/Deserialization/DeserializationError.hpp:85:25:   required from here
C:\Users\\AppData\Local\Arduino15\packages\esp32\hardware\esp32\3.0.0-alpha3\cores\esp32/pgmspace.h:52:9: error: 'typeof_' was not declared in this scope; did you mean 'typeof'?
   52 |   typeof(addr) _addr = (addr); \
C:\Users\\AppData\Local\Arduino15\packages\esp32\hardware\esp32\3.0.0-alpha3\cores\esp32/pgmspace.h:54:1: error: void value not ignored as it ought to be
   54 | })
      | ^
Mehrere Bibliotheken wurden für "WiFi.h" gefunden
 Benutzt: C:\Users\\AppData\Local\Arduino15\packages\esp32\hardware\esp32\3.0.0-alpha3\libraries\WiFi
 Nicht benutzt: D:\Arduino\libraries\WiFi
 Nicht benutzt: D:\Arduino\libraries\WiFiNINA
exit status 1
'using ESP32SPISlave = class arduino::esp32::spi::slave::Slave' {aka 'class arduino::esp32::spi::slave::Slave'} has no member named 'remained'`

Bei mir ist es das erste Arduino-Projekt und auch ich wäre für jeden Hinweis zur Problemlösung dankbar.

the-real-orca, 2024-04-14:
Je nachdem welche Entwicklungsumbebung ihr verwendet, müsst ihr die Libraries manuell laden & einbinden. Ich benutze VS Code mit PlatformIO, da werden sie über platformio.ini automatisch geladen.

Das Log schaut so aus, als ob essenzielle System-Libraries nicht richtig installiert sind. Ist das ESP32 SDK richtig installiert? Ich würde vorschlagen, ihr testet einmal mit einem „Hello World“ Beispiel (z.B: LED blinken lassen) ob das System richtig installiert ist und kompilieren und Upload korrekt funktionieren. Dazu gibt es dutzende Bsp. Im Netz und auf YouTube. Wenn das läuft, ist der nächste Schritt mit dem LX79x ...

Senserich, 2024-04-14:
Vielen Dank für die Antwort. In meinem Fall ist es so, daß das Programm "Blink" einwandfrei funktioniert. Auch hatte ich die ursprüngliche LX90-Version von ahermann86 bereits erfolgreich mit Arduino 1.18.19 aufgespielt. Die Benutzeroberfläche war im Browser per WLAN auch erreichbar. Allerdings habe ich erst dann mitbekommen, daß ich schon die neue Platine v1.1 besitze und diese Version nicht verwenden kann.
An Bibliotheken habe ich jetzt alles Verfügbare mit dem Namen ESP installiert - leider ohne Erfolg. Werde morgen einen neuen Versuch starten.

Senserich, 2024-04-15:
Ich habe nun meine beiden Arduino-Versionen deinstalliert, Windows neu gestartet und die Version 1.8.18 installiert.
Zusätzliche Bibliotheken wurden erst hinzugefügt, wenn entsprechende Fehlermeldugen beim Kompilieren auftraten.
Leider war das Resultat am Ende das gleiche wie vorher.

Hier die verkürzte Auflistung der für mich entscheidenden Fehlermeldungen:
```
Arduino: 1.8.18 (Windows 10), Board: "DOIT ESP32 DEVKIT V1, 80MHz, 921600, None, Disabled"

error: 'using ESP32SPISlave = class arduino::esp32::spi::slave::Slave' {aka 'class arduino::esp32::spi::slave::Slave'} has no member named 'available'
error: 'using ESP32SPISlave = class arduino::esp32::spi::slave::Slave' {aka 'class arduino::esp32::spi::slave::Slave'} has no member named 'size'
error: 'using ESP32SPISlave = class arduino::esp32::spi::slave::Slave' {aka 'class arduino::esp32::spi::slave::Slave'} has no member named 'pop'
error: 'using ESP32SPISlave = class arduino::esp32::spi::slave::Slave' {aka 'class arduino::esp32::spi::slave::Slave'} has no member named 'remained'
```
Die erste Zeile der Datei HAL_LX790_V1_1.cpp, in der ein Fehler angezeigt wird, lautet:
```
// read data via SPI
  if (tm1668.remained() == 0)
    tm1668.queue(spi_slave_rx_buf, sizeof spi_slave_rx_buf);
```
Das Kompilieren wurde an dieser abgebrochen (siehe auch Felerprotokoll von wlad2288).
Leider bin ich nun vollkommen ratlos.

Senserich, 2024-04-22:
Das Problem ist gelöst. Es lag an der Bibliothek ESP32SPISlave bzw. deren neuester Version 0.6.0. Diese ist nicht mehr kompatibel mit der Datei HAL_LX790_V1_1.cpp. Anhand des Datums der Veröffentlichung und der Release-Historie der Bibliothek habe ich Version 0.3.0 installiert, und siehe da.......Projekt auf ESP32 hochgeladen - Bedienoberfläche im Browser sichtbar. Am Wochenende baue ich das Adapterkabel ein und bin schon jetzt sehr gespannt.

Wlad2288, 2024-04-23:
> Das Problem ist gelöst. Es lag an der Bibliothek ESP32SPISlave bzw. deren neuester Version 0.6.0. Diese ist nicht mehr kompatibel mit der Datei HAL_LX790_V1_1.cpp. Anhand des Datums der Veröffentlichung und der Release-Historie der Bibliothek habe ich Version 0.3.0 installiert, und siehe da.......Projekt auf ESP32 hochgeladen - Bedienoberfläche im Browser sichtbar. Am Wochenende baue ich das Adapterkabel ein und bin schon jetzt sehr gespannt.

Perfekt! ... vielen Dank.
Genau daran lag es.

Die Tage kommen die letzten Komponenten und dann kann ich alles einbauen und testen.

the-real-orca, 2024-05-02:
Sehr gut, freut mich, dass ihr das Problem lösen konntet.
Ich habe zur Zeit leider viel zu viele offene Baustellen, aber wenn ich dann wieder Zeit finde, werde ich den Code auf die aktuellen Bibliotheken nach ziehen.

Wlad2288, 2024-05-07:
@the-real-orca @ahermann86

Besten Danke euch beiden für dieses Projekt!
Ich habe nun endlich alles verlötet, eingebaut und getestet.
Alles hat einwandfrei auf Anhieb funktioniert - klasse!

Sogar die Einbindung in Homeassistant klappt super :)

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

Aus meiner Sicht kann das Issue geschlossen werden.

VG,
Wlad

Senserich, 2024-05-07:
Auch ich kann berichten, daß alles einwandfrei läuft. Allerdings wurde von mir der Ein/Aus-Schalter aus der Bedienoberfläche entfernt, um den Roboter nicht versehentlich auszuschalten. Ich bekomme ihn sonst so schnell nicht wieder an, da er ca. 200 km von meinem Zuhause seine Arbeit verrichtet.
Auch von mir noch einmal vielen Dank an die Ersteller des Projekts !

jha81, 2024-06-24:
Moin,

erstmal Hut ab so etwas zu programmieren !
Ich habe auch die Version 790.1, leider bekomme ich das auf meinem Board nicht zum laufen... Die Version für das alte Board läuft. Lade ich jedoch jetzt die 790.1 auf das Board bekomme ich diesen Fehler im Seriellen Monitor:

17:14:54.996 -> ets Jul 29 2019 12:21:46
17:14:54.996 ->
17:14:54.996 -> rst:0x1 (POWERON_RESET),boot:0x13 (SPI_FAST_FLASH_BOOT)
17:14:54.996 -> configsip: 0, SPIWP:0xee
17:14:54.996 -> clk_drv:0x00,q_drv:0x00,d_drv:0x00,cs0_drv:0x00,hd_drv:0x00,wp_drv:0x00
17:14:54.996 -> mode:DIO, clock div:1
17:14:54.996 -> load:0x3fff0030,len:1288
17:14:55.030 -> load:0x40078000,len:13872
17:14:55.030 -> load:0x40080400,len:4
17:14:55.030 -> ho 8 tail 4 room 4
17:14:55.030 -> load:0x40080404,len:3048
17:14:55.030 -> entry 0x40080590
17:14:55.411 -> Build date: Jun 24 2024 time: 17:03:50
17:14:55.622 -> Failed to read file, using default configuration
17:14:55.722 -> start AP..
17:14:55.929 -> AP SSID: LX790
17:14:55.929 -> AP password:
17:14:55.929 -> AP IP address: 192.168.4.1

Im Moment stehe ich auf dem Schlauch, da ich genauso vorgegangen bin, wie mit der "alten Version", die ohne Probleme läuft... Keine Ahnung, ob ich etwas vergessen habe !? So wie ich es verstanden habe ist das Verzeichnis LX790_V1_1 herunterzuladen, Data Ordner rüberschieben, WLAN Daten anpassen und Hochladen.... Beim Kompilieren gibt es keinerlei Fehlermeldungen. Vielleicht hat ja jemand eine Idee ? Würde mich sehr über Nachricht freuen !

Danke vorab !
Jan

Wlad2288, 2024-07-07:
Hi!
Laut Log hat er einen AccessPoint geöffnet.
Schau mal ob du ein WLAN mit dem Namen LX790 sehen kannst.
Wenn du dich damit verbindest, kannst du einstellen, mit welchem WLAN der Robi sich verbinden soll.

VG,
Wlad

Wlad2288, 2024-07-07:
@the-real-orca

Ich habe das gleiche jetzt in einem zweiten Robi eingebaut. Alles, bis auf die Stopp Taste funktioniert.

Hast du eine Idee?

VG,
Wlad

jha81, 2024-07-15:
Danke @ Wlad2288 !!
 Genau so hat es funktioniert.... einfach mit dem WLAN Verbinden und die Daten eintragen ! Super...

Nachdem ich auf der Platine ein Kabel vergessen und zwei am Optokopler vertauscht hatte, funktioniert jetzt alles !!!

Vielen Danke dafür !!!

LG
Jan

vikblau, 2025-04-17:
@Wlad2288 Kannst du mir deine Einträge für den Roboter in der Home-Assistant Config zusenden?
Bekomme das mit der Abfrage nicht richtig hin, dein Dashboard sieht super aus!

Wlad2288, 2025-04-21:
Folgendes habe ich in die config yaml geschrieben:

```
rest_command:
  bernie_start:
    url: http://<<IP>>/cmd?parm=startmow&value=1
  bernie_stop:
    url: http://<<IP>>/cmd?parm=stop&value=1000
  bernie_home:
    url: http://<<IP>>/cmd?parm=homemow&value=1

rest:
  - resource: http://<<IP>>/status
    sensor:
      - name: "bernie_msg"
        value_template: "{{ value_json.msg }}"
      - name: "bernie_battery"
        value_template: "{{ value_json.battery }}"
      - name: "bernie_digits"
        value_template: "{{ value_json.digits }}"
      - name: "mbernie_mode"
        value_template: "{{ value_json.mode }}"
      - name: "mbernie_lock"
        value_template: "{{ value_json.lock }}"
```

Thread 8 (2023-04-16):

Fehler E4 nach Einbau

BoxSo, 2023-04-16:
Hallo,

zunächst mal: Hammer Projekt! Wifi - Anbindung ohne Cloud-Zwang ist mehr als spitze! Ich habe die Steuerung und den Adapter gestern zusammengebaut und auch akribisch durchgemessen vor dem Einbau in den Mäher. Nach dem ersten einschalten hat er auch brav mit Pxxxx hochgezählt, dann kam die PIN-Eingabe. Nach der PIN-Eingabe zeigt der Mäher jetzt allerdings Fehler E4 an. Irgendeine Idee was das sein könnte? Steckverbindungen habe ich schon alle auf festen Sitz geprüft.
