ahermann86/LX79x_WiFi/pic/Schaltplan.pdf

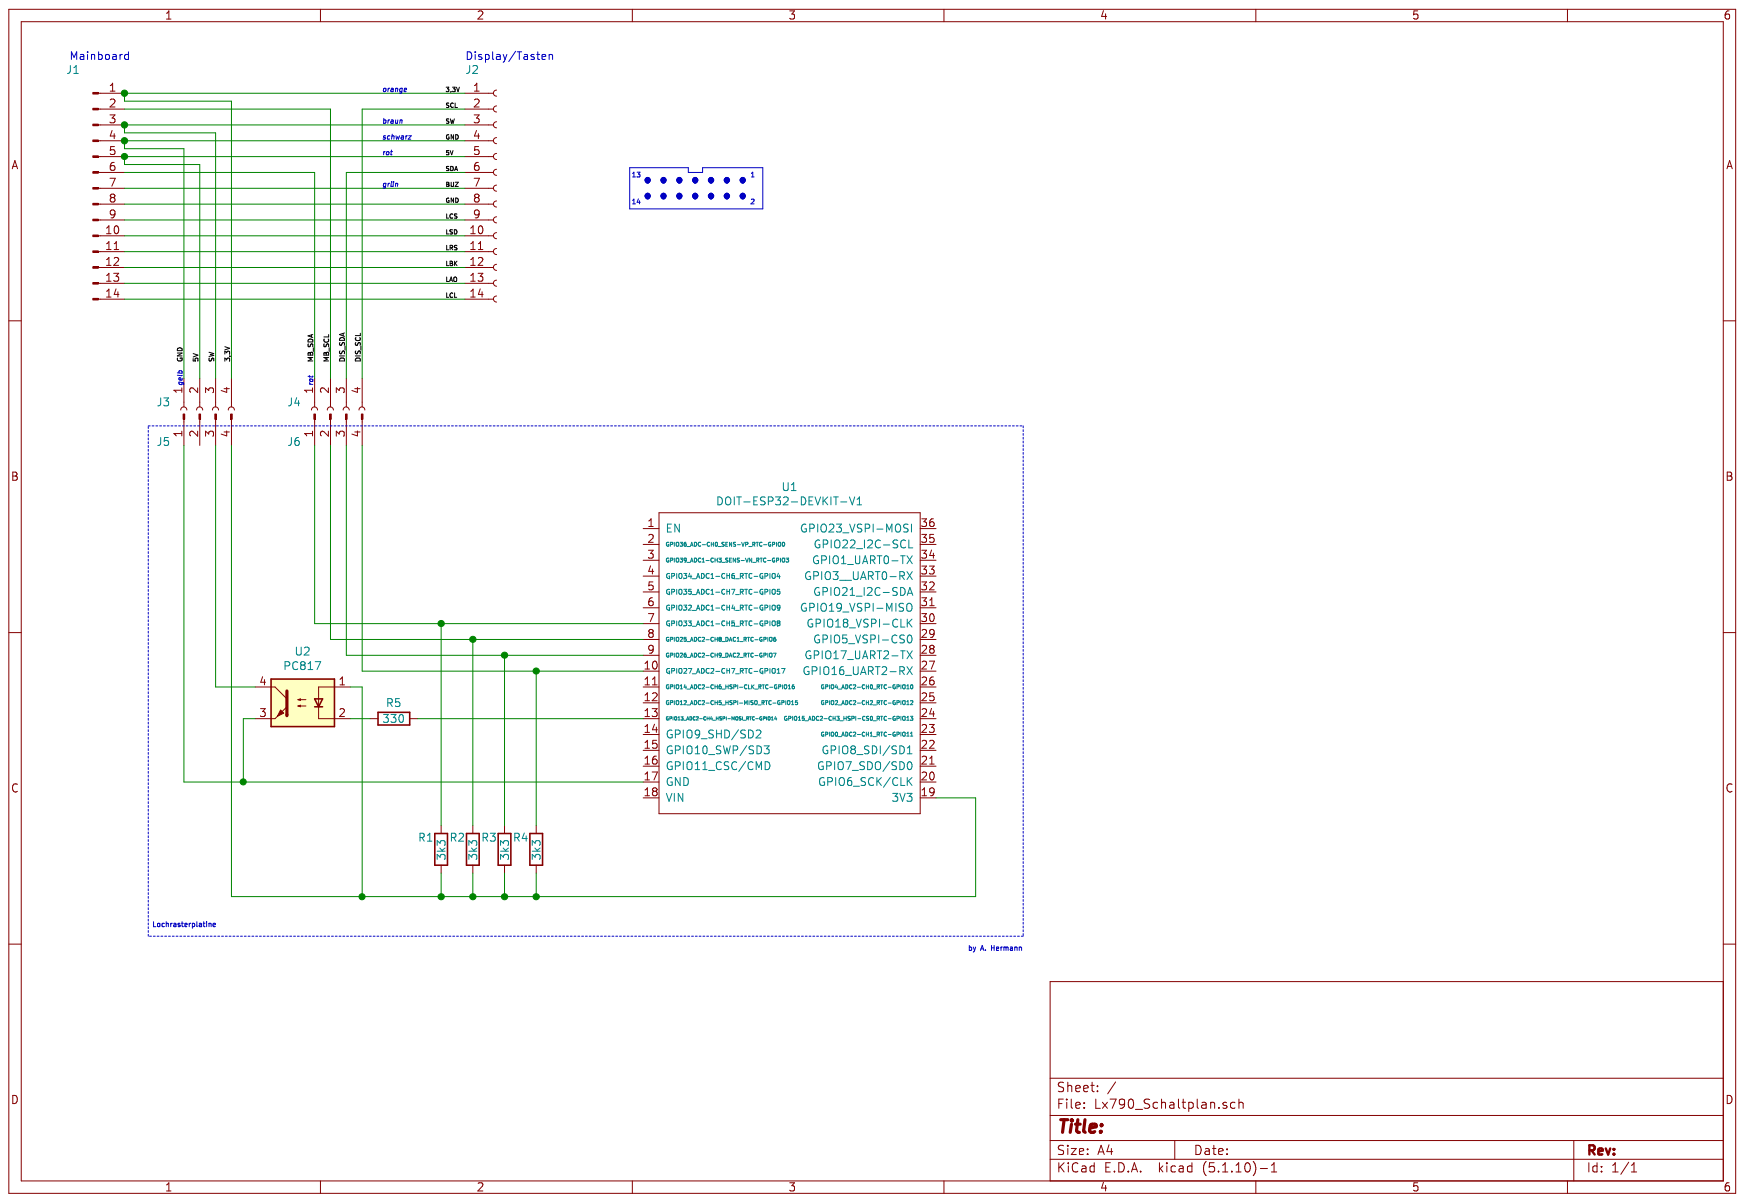
[picture p24: page 1]
