ahermann86/LX79x_WiFi/(commit log)

2021-09-02 Add files via upload
    SW und 5V war vertauscht, Optokoppler zum Einschalten ergänzt
2021-09-02 Update README.md
    Einschalten und Update ergänzt
2021-09-02 Add files via upload
    Text und Web Ausgabe optimiert / umgebaut, OTA Update und "I/O" Funktion eingebaut
2022-05-30 Update README.md
    New link for ESP32 Core installation
